LoKoTrOnIc/hellen121vag/modules/readme.md

This folder contains footprints/gerbers/PDFs which hellen-one framework would merge into your frame design.

See https://github.com/andreika-git/hellen-one/wiki for module documentation
