LoKoTrOnIc/hellen121vag/boards/hellen121vag-d/board/hellen121vag-d.png

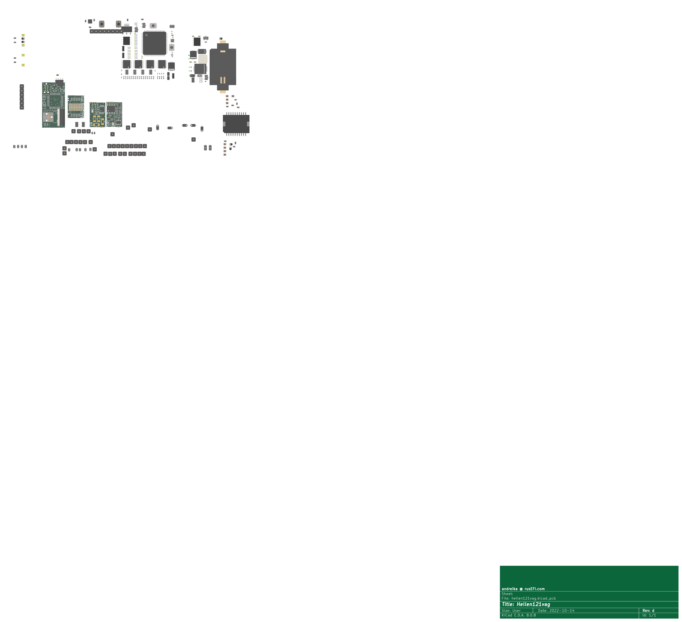
boards/hellen121vag-d/board/hellen121vag-d.png
