LoKoTrOnIc/hellen121vag/boards/hellen121vag-d/board/misc/hellen121vag-d-bottom.png

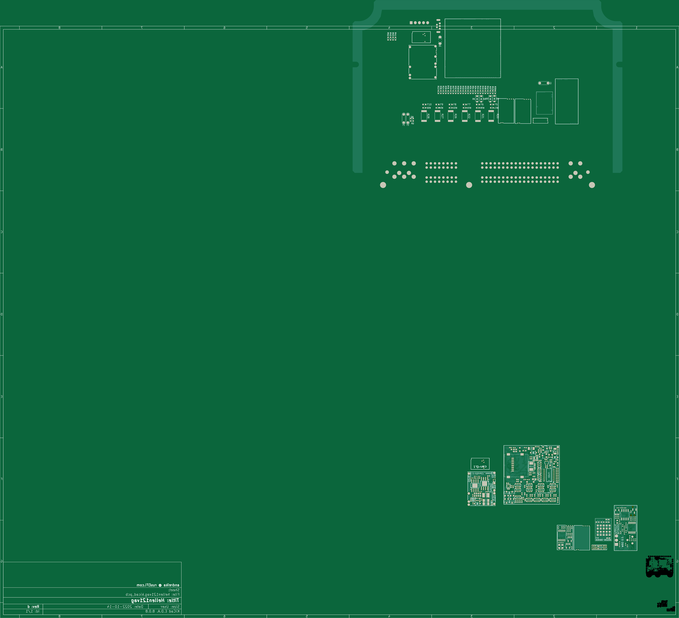
boards/hellen121vag-d/board/misc/hellen121vag-d-bottom.png
