LoKoTrOnIc/hellen121vag/boards/hellen121vag-d/board/misc/hellen121vag-d-top.png

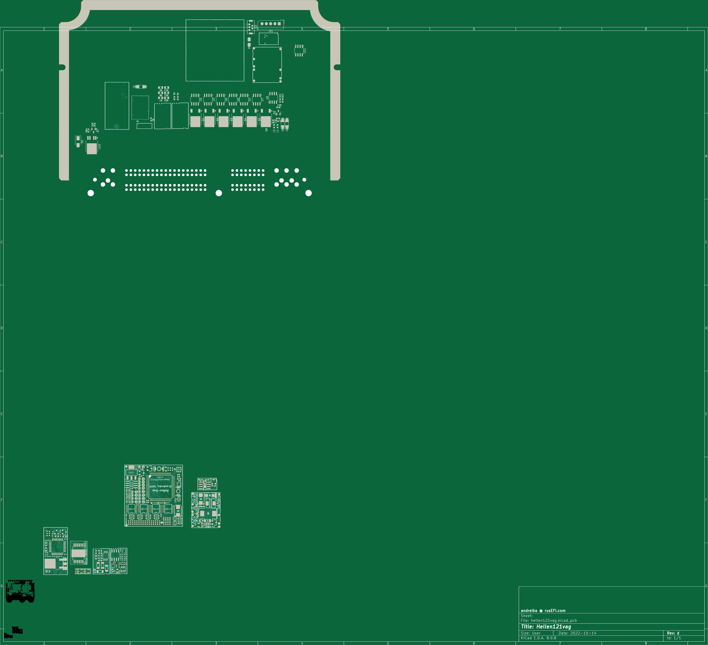
boards/hellen121vag-d/board/misc/hellen121vag-d-top.png
