LoKoTrOnIc/hellen121vag/modules/wbo/wbo-0.3-migration.png

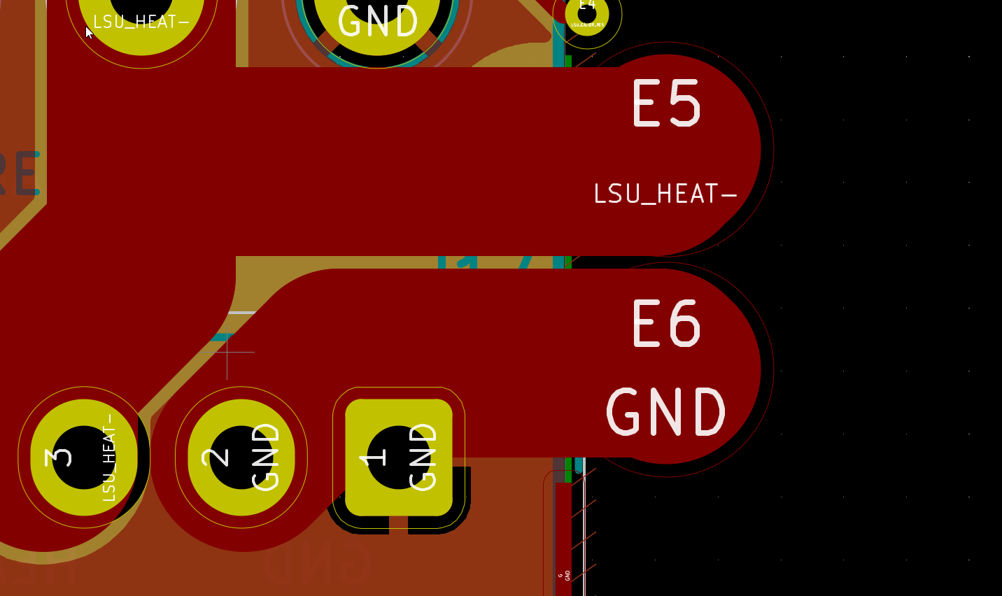
modules/wbo/wbo-0.3-migration.png
