LoKoTrOnIc/hellen121vag/modules/ign8/0.1/ign8-BOM.csv

Comment | Designator | Footprint | LCSC Part #
100n | C460, C461 | C0603 | C14663
Module:ign8/0.1 | M460
10 | R461, R462, R463, R464, R466, R467, R468, R469 | R0603 | C22859
SN74LVC4245APWR | U460 | TSSOP24 | C7859
