LoKoTrOnIc/hellen121vag/modules/knock/0.1/knock-BOM.csv

Comment | Designator | Footprint | LCSC Part #
100n | C470 | C0603 | C14663
3.3n | C471 | C0603 | C1613
330p | C472 | C0603 | C1664
47p | C473 | C0603 | C1671
680p | C474 | C0603 | C1630
Module:knock/0.1 | M470
470k | R470 | R0603 | C23178
100k | R471, R473 | R0603 | C25803
12k | R472 | R0603 | C22790
33k | R474 | R0603 | C4216
LMV321IDBVR | U470, U471 | SOT23-5 | C7972
