LoKoTrOnIc/hellen121vag/modules/power12/0.2/power12-BOM.csv

Comment | Designator | Footprint | LCSC Part #
47u | C410, C412 | C1206 | C96123
100n | C411, C413 | C0603 | C14663
1N4148WS | D410, D412, D413, D414 | SOD-323 | C2128
PSM712-LF | D411 | SOT-23 | C32677
B5819W | D416, D417 | SOD-123 | C8598
SMCJ30A | D418 | SMC | C310046
SMD1206P050TF/24 | F410 | SMD1206 | C209741
Hellen One : Power-12V Module interface | M410
6.8k | R410, R413 | R0603 | C23212
33k | R411 | R0603 | C4216
MIC5205-3.3YM5 | U410 | SOT23-5 | C37970
