LoKoTrOnIc/hellen121vag/boards/hellen121vag-d/frame/121vag-schematic.pdf

DC Motor Discrete inputs General purpose bus LS & HS outputs

Analog/digital Heater negative Power GND

enable the CAN WAKEUP
input will be unavailable.

analog signal VR-DISCRETE
instead of the knock signal

File: hellen121vag.kicad_sch Sheet: / andreika @ rusEFI.comm


Id: 3/6 Title: File: LS4.kicad_sch Sheet: /LS/ R43


Id: 5/6 Title: File: IGN6.kicad_sch Sheet: /Ignition/ F10




Id: 9/6 Title: File: egt.kicad_sch Sheet: /EGT/
