LoKoTrOnIc/hellen121vag/hellen121vag.kicad_pcb

## KiCad design hellen121vag.kicad_pcb (2025-12-17)

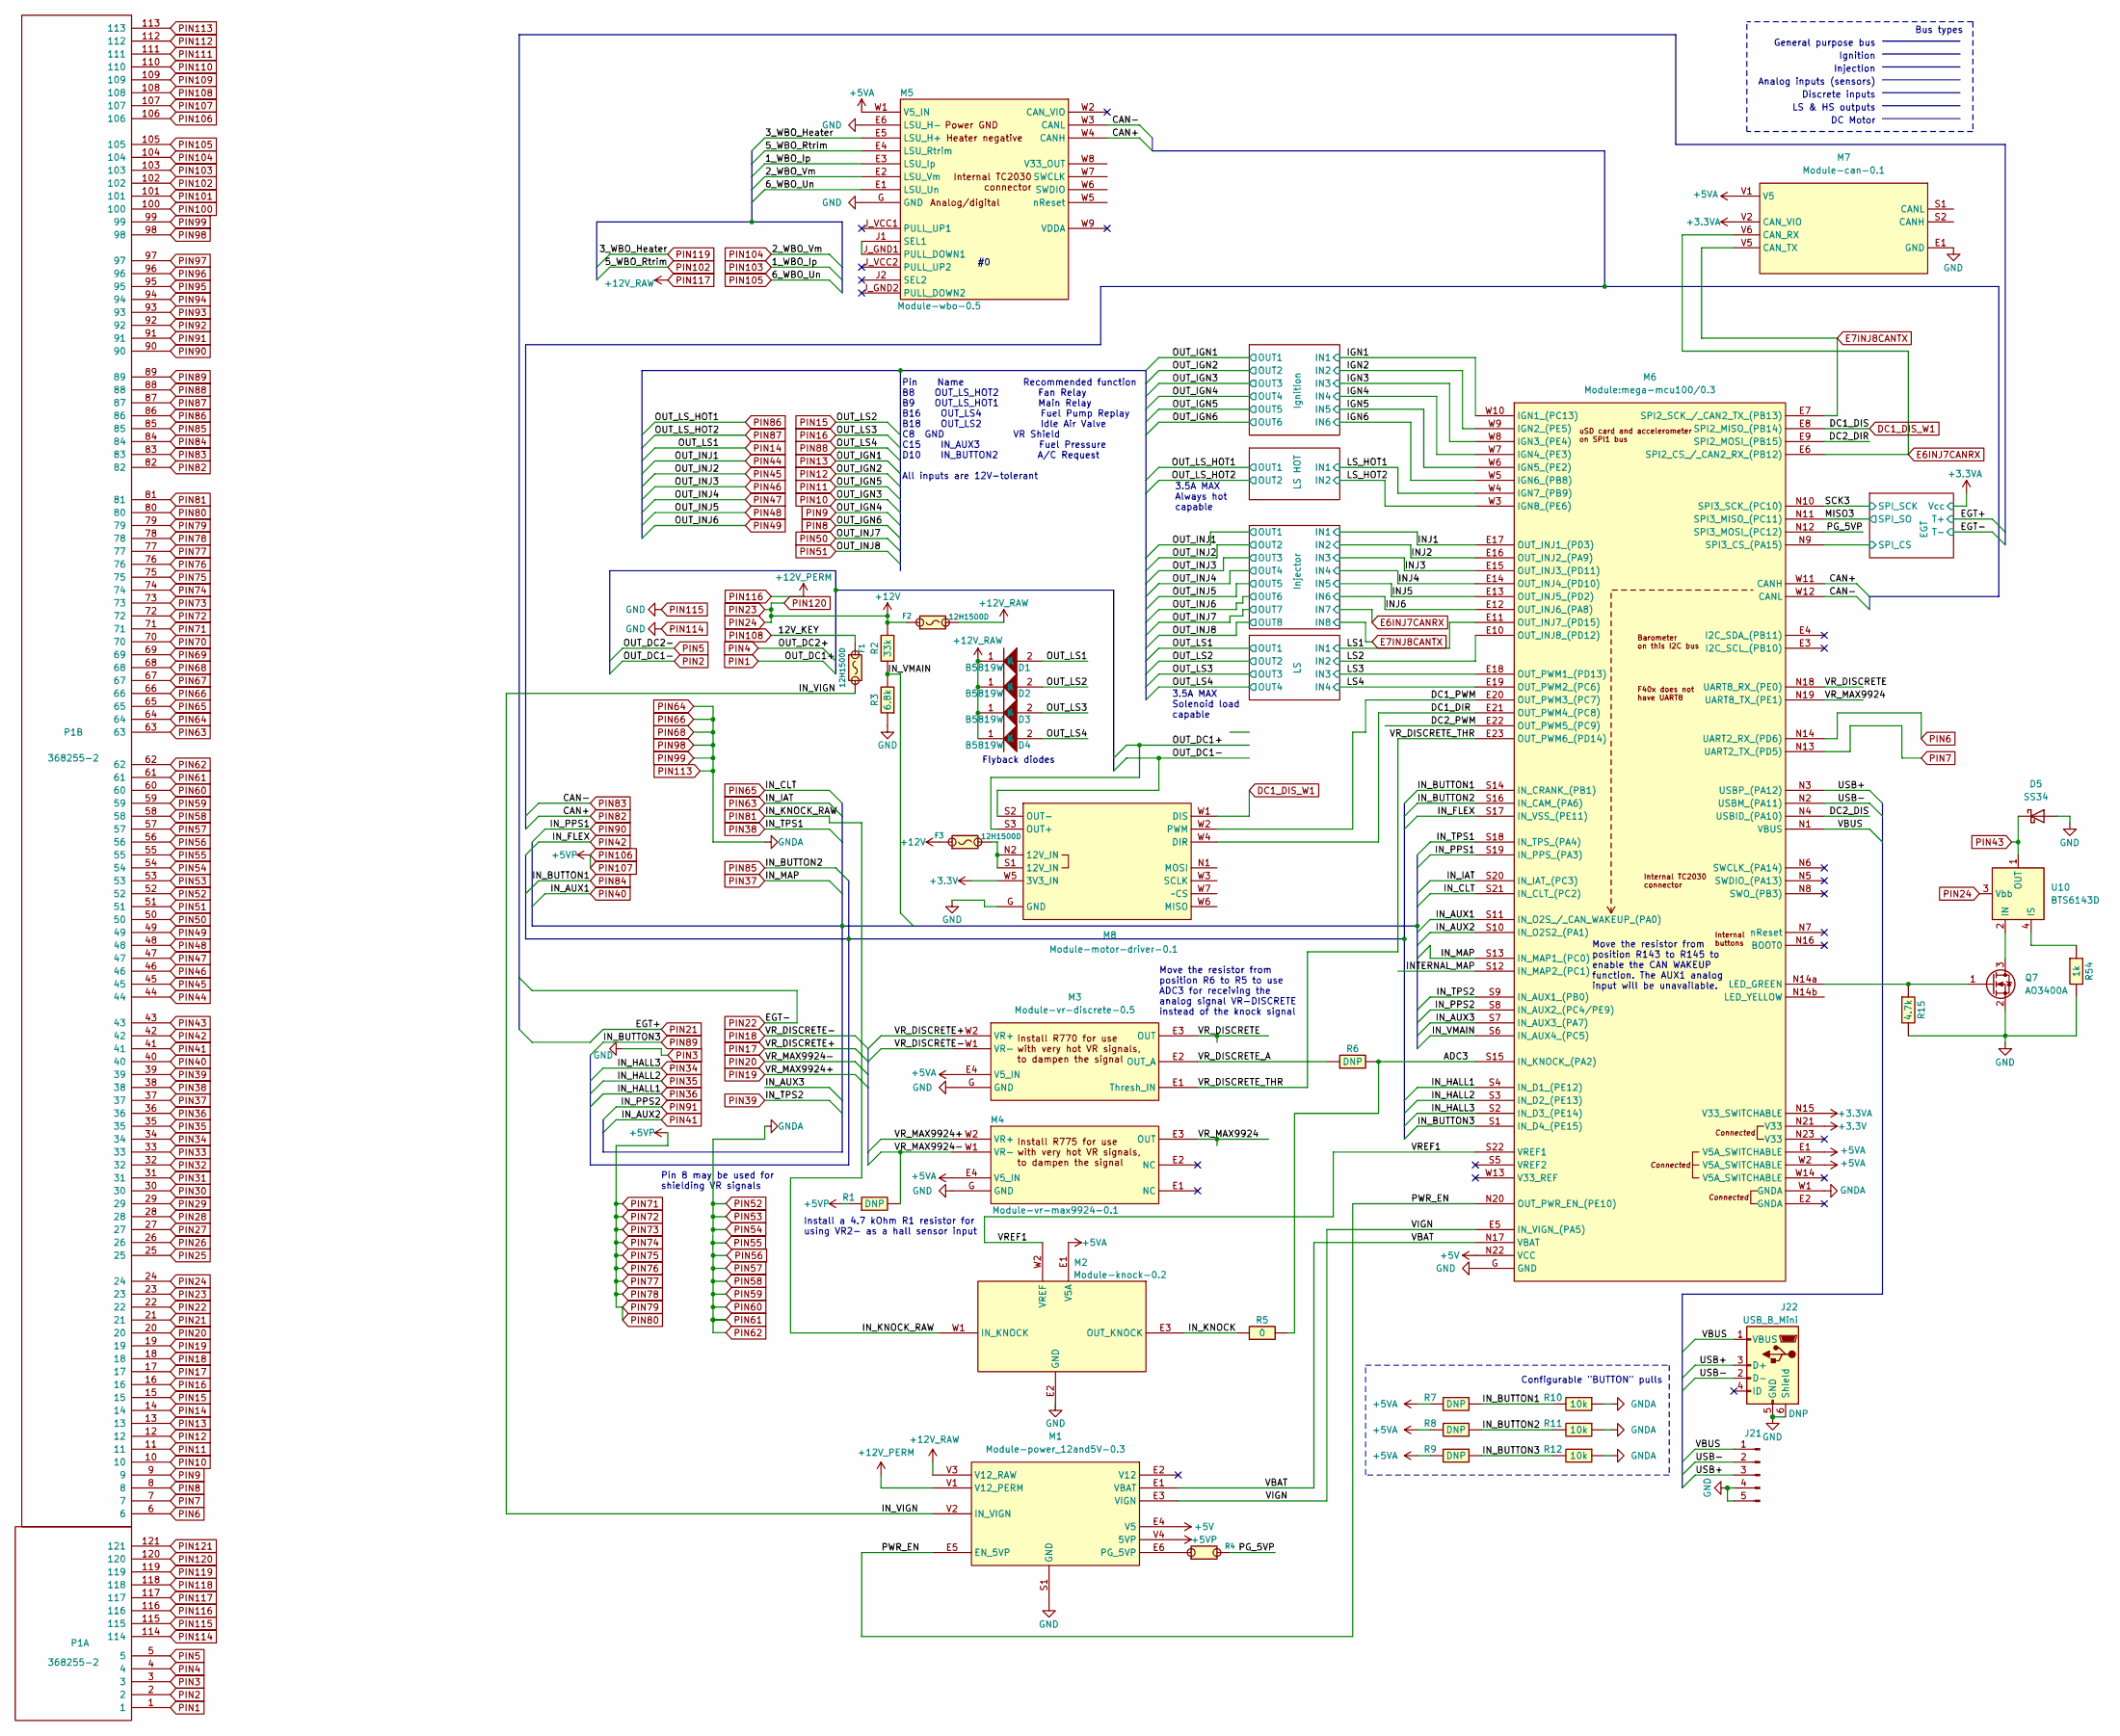
[picture p32: schematic hellen121vag.kicad_sch]

Parts:
D1, D2, D3, D4: B5819W; SOD-123; LCSC C8598
D5: SS34; D_SMA
F1, F2, F3: 12H1500D; PAD-1206-PAD; LCSC C182446
J21: Conn_01x05_Male; Molex_SPOX_5267-05A_1x05_P2.50mm_Vertical
J22: USB_B_Mini; USB-MINI-B-VERTICAL
M1: Module-power_12and5V-0.3; power_12and5V
M2: Module-knock-0.2; knock
M3: Module-vr-discrete-0.5; vr-discrete
M4: Module-vr-max9924-0.1; vr-max9924
M5: Module-wbo-0.5; wbo
M6: Module:mega-mcu100/0.3; mega-mcu100
M7: Module-can-0.1; can
M8: Module-motor-driver-0.1; motor-driver
P1: 368255-2
Q7: AO3400A; SOT-23
R1: 4.7k; R0603
R2: 33k; R0603; LCSC C4216
R3: 6.8k; R0603; LCSC C23212
R4: Jumper-Pad-Pad; PAD-0805-PAD; LCSC C17477
R5: 0; R0603; LCSC C21189
R6: 0; R0603
R7, R8, R9: DNP; R0805
R10, R11, R12: 10k; R0805; LCSC C17414
R15: 4.7k; R0603; LCSC C21189
R54: 1k; R0603; LCSC C21189
U10: BTS6143D; TO-252-4

Connections:
+3.3V: M6.N21 (V33), M8.W5 (3V3_IN)
+3.3VA: M6.N15 (V33_SWITCHABLE), M7.V2 (CAN_VIO); also elsewhere on the board
+5V: M1.E4 (V5), M6.N22 (VCC)
+5VA: M2.E1 (V5A), M3.E4 (V5_IN), M4.E4 (V5_IN), M5.W1 (V5_IN), M6.E1 (V5A_SWITCHABLE), M6.W2 (V5A_SWITCHABLE), M7.V1 (V5), R7.2, R8.2, R9.2
/ADC3: M6.S15 (IN_KNOCK_(PA2)), R5.2, R6.2
/DC1_DIR: M6.E21 (OUT_PWM4_(PC8)), M8.W4 (DIR)
/DC1_PWM: M6.E20 (OUT_PWM3_(PC7)), M8.W2 (PWM)
/DC2_DIR: M6.E9 (SPI2_MOSI_(PB15))
/DC2_DIS: M6.N4 (USBID_(PA10))
/DC2_PWM: M6.E22 (OUT_PWM5_(PC9))
/EGT/SPI_CS: M6.N9 (SPI3_CS_(PA15)); also elsewhere on the board
/IGN1: M6.W10 (IGN1_(PC13)); also elsewhere on the board
/IGN2: M6.W9 (IGN2_(PE5)); also elsewhere on the board
/IGN3: M6.W8 (IGN3_(PE4)); also elsewhere on the board
/IGN4: M6.W7 (IGN4_(PE3)); also elsewhere on the board
/IGN5: M6.W6 (IGN5_(PE2)); also elsewhere on the board
/IGN6: M6.W5 (IGN6_(PB8)); also elsewhere on the board
/INJ1: M6.E17 (OUT_INJ1_(PD3)); also elsewhere on the board
/INJ2: M6.E16 (OUT_INJ2_(PA9)); also elsewhere on the board
/INJ3: M6.E15 (OUT_INJ3_(PD11)); also elsewhere on the board
/INJ4: M6.E14 (OUT_INJ4_(PD10)); also elsewhere on the board
/INJ5: M6.E13 (OUT_INJ5_(PD2)); also elsewhere on the board
/INJ6: M6.E12 (OUT_INJ6_(PA8)); also elsewhere on the board
/INTERNAL_MAP: M6.S12 (IN_MAP2_(PC1))
/IN_AUX3: M6.S7 (IN_AUX3_(PA7))
/IN_KNOCK: M2.E3 (OUT_KNOCK), R5.1
/IN_VIGN: F1.2, M1.V2 (IN_VIGN)
/IN_VMAIN: M6.S6 (IN_AUX4_(PC5)), R2.1, R3.2
/LS1: M6.E11 (OUT_INJ7_(PD15)); also elsewhere on the board
/LS2: M6.E10 (OUT_INJ8_(PD12)); also elsewhere on the board
/LS3: M6.E18 (OUT_PWM1_(PD13)); also elsewhere on the board
/LS4: M6.E19 (OUT_PWM2_(PC6)); also elsewhere on the board
/LS_HOT1: M6.W4 (IGN7_(PB9)); also elsewhere on the board
/LS_HOT2: M6.W3 (IGN8_(PE6)); also elsewhere on the board
/MISO3: M6.N11 (SPI3_MISO_(PC11)); also elsewhere on the board
/PG_5VP: M6.N12 (SPI3_MOSI_(PC12)), R4.2
/PWR_EN: M1.E5 (EN_5VP), M6.N20 (OUT_PWR_EN_(PE10))
/SCK3: M6.N10 (SPI3_SCK_(PC10)); also elsewhere on the board
/USB+: J21.3, J22.3 (D+), M6.N3 (USBP_(PA12))
/USB-: J21.2, J22.2 (D-), M6.N2 (USBM_(PA11))
/VBAT: M1.E1 (VBAT), M6.N17 (VBAT)
/VBUS: J21.1, J22.1 (VBUS), M6.N1 (VBUS)
/VIGN: M1.E3 (VIGN), M6.E5 (IN_VIGN_(PA5))
/VREF1: M2.W2 (VREF), M6.S22 (VREF1)
/VR_DISCRETE: M3.E3 (OUT), M6.N18 (UART8_RX_(PE0))
/VR_DISCRETE_A: M3.E2 (OUT_A), R6.1
/VR_DISCRETE_THR: M3.E1 (Thresh_IN), M6.E23 (OUT_PWM6_(PD14))
/VR_MAX9924: M4.E3 (OUT), M6.N19 (UART8_TX_(PE1))
DC1_DIS_W1: M6.E8 (SPI2_MISO_(PB14)), M8.W1 (DIS)
E6INJ7CANRX: M6.E6 (SPI2_CS_/_CAN2_RX_(PB12)), M7.V6 (CAN_RX); also elsewhere on the board
E7INJ8CANTX: M6.E7 (SPI2_SCK_/_CAN2_TX_(PB13)), M7.V5 (CAN_TX); also elsewhere on the board
unnamed: F3.2, M8.N2 (12V_IN), M8.S1 (12V_IN)
unnamed: M1.E6 (PG_5VP), R4.1
unnamed: M5.J1 (SEL1), M5.J_GND1 (PULL_DOWN1)
unnamed: M6.N14a (LED_GREEN), Q7.1 (G), R15.1
unnamed: Q7.3 (D), U10.2 (IN)
unnamed: R54.1, U10.4 (IS)
PIN1: M8.S3 (OUT+), P1.1
PIN2: M8.S2 (OUT-), P1.2
PIN4: P1.4
PIN5: P1.5
PIN6: M6.N14 (UART2_RX_(PD6)), P1.6
PIN7: M6.N13 (UART2_TX_(PD5)), P1.7
PIN8: P1.8; also elsewhere on the board
PIN9: P1.9; also elsewhere on the board
PIN10: P1.10; also elsewhere on the board
PIN11: P1.11; also elsewhere on the board
PIN12: P1.12; also elsewhere on the board
PIN13: P1.13; also elsewhere on the board
PIN14: D1.2 (A), P1.14; also elsewhere on the board
PIN15: D2.2 (A), P1.15; also elsewhere on the board
PIN16: D3.2 (A), P1.16; also elsewhere on the board
PIN17: M3.W2 (VR+), P1.17
PIN18: M3.W1 (VR-), P1.18
PIN19: M4.W2 (VR+), P1.19
PIN20: M4.W1 (VR-), P1.20, R1.2
PIN21: P1.21; also elsewhere on the board
PIN22: P1.22; also elsewhere on the board
PIN25: P1.25
PIN26: P1.26
PIN27: P1.27
PIN28: P1.28
PIN29: P1.29
PIN30: P1.30
PIN31: P1.31
PIN32: P1.32
PIN33: P1.33
PIN34: M6.S2 (IN_D3_(PE14)), P1.34
PIN35: M6.S3 (IN_D2_(PE13)), P1.35
PIN36: M6.S4 (IN_D1_(PE12)), P1.36
PIN37: M6.S13 (IN_MAP1_(PC0)), P1.37
PIN38: M6.S18 (IN_TPS_(PA4)), P1.38
PIN39: M6.S9 (IN_AUX1_(PB0)), P1.39
PIN40: M6.S11 (IN_O2S_/_CAN_WAKEUP_(PA0)), P1.40
PIN41: M6.S10 (IN_O2S2_(PA1)), P1.41
PIN42: M6.S17 (IN_VSS_(PE11)), P1.42
PIN43: D5.1 (K), P1.43, U10.1 (OUT), U10.5 (OUT)
PIN44: P1.44; also elsewhere on the board
PIN45: P1.45; also elsewhere on the board
PIN46: P1.46; also elsewhere on the board
PIN47: P1.47; also elsewhere on the board
PIN48: P1.48; also elsewhere on the board
PIN49: P1.49; also elsewhere on the board
PIN50: P1.50; also elsewhere on the board
PIN51: P1.51; also elsewhere on the board
PIN63: M6.S20 (IN_IAT_(PC3)), P1.63
PIN65: M6.S21 (IN_CLT_(PC2)), P1.65
PIN67: P1.67
PIN69: P1.69
PIN70: P1.70
PIN81: M2.W1 (IN_KNOCK), P1.81
PIN82: M5.W4 (CANH), M6.W11 (CANH), P1.82
PIN83: M5.W3 (CANL), M6.W12 (CANL), P1.83
PIN84: M6.S14 (IN_CRANK_(PB1)), P1.84, R7.1, R10.2
PIN85: M6.S16 (IN_CAM_(PA6)), P1.85, R8.1, R11.2
PIN86: P1.86; also elsewhere on the board
PIN87: P1.87; also elsewhere on the board
PIN88: D4.2 (A), P1.88; also elsewhere on the board
PIN89: M6.S1 (IN_D4_(PE15)), P1.89, R9.1, R12.2
PIN90: M6.S19 (IN_PPS_(PA3)), P1.90
PIN91: M6.S8 (IN_AUX2_(PC4/PE9)), P1.91
PIN92: P1.92
PIN93: P1.93
PIN94: P1.94
PIN95: P1.95
PIN96: P1.96
PIN97: P1.97
PIN100: P1.100
PIN101: P1.101
PIN102: M5.E4 (LSU_Rtrim), P1.102
PIN103: M5.E3 (LSU_Ip), P1.103
PIN104: M5.E2 (LSU_Vm), P1.104
PIN105: M5.E1 (LSU_Un), P1.105
PIN106: M1.V4 (5VP), P1.71, P1.72, P1.73, P1.74, P1.75, P1.76, P1.77, P1.78, P1.79, P1.80, P1.106, P1.107, R1.1
PIN108: F1.1, P1.108
PIN109: P1.109
PIN110: P1.110
PIN111: P1.111
PIN112: P1.112
PIN113: M6.W1 (GNDA), P1.52, P1.53, P1.54, P1.55, P1.56, P1.57, P1.58, P1.59, P1.60, P1.61, P1.62, P1.64, P1.66, P1.68, P1.98, P1.99, P1.113, R10.1, R11.1, R12.1
PIN114: D5.2 (A), J21.4, J21.5, J22.5 (GND), J22.6 (Shield), M1.S1 (GND), M2.E2 (GND), M3.G (GND), M4.G (GND), M5.E6 (LSU_H-), M5.G (GND), M6.G (GND), M7.E1 (GND), M8.G (GND), P1.3, P1.114, P1.115, Q7.2 (S), R3.1, R15.2, R54.2; also elsewhere on the board
PIN116: M1.V1 (V12_PERM), P1.116
PIN117: D1.1 (K), D2.1 (K), D3.1 (K), D4.1 (K), F2.2, M1.V3 (V12_RAW), P1.117
PIN118: P1.118
PIN119: M5.E5 (LSU_H+), P1.119
PIN120: F2.1, F3.1, P1.23, P1.24, P1.120, R2.2, U10.3 (Vbb)
PIN121: P1.121

Notes on the sheet:
Analog inputs (sensors)
Install a 4.7 kOhm R1 resistor for using VR2- as a hall sensor input
Injection
Pin Name Recommended function B8 OUT_LS_HOT2 Fan Relay B9 OUT_LS_HOT1 Main Relay B16 OUT_LS4 Fuel Pump Replay B18 OUT_LS2 Idle Air Valve C8 GND VR Shield C15 IN_AUX3 Fuel Pressure D10 IN_BUTTON2 A/C Request All inputs are 12V-tolerant
Ignition
Move the resistor from position R143 to R145 to enable the CAN WAKEUP function. The AUX1 analog input will be unavailable.
Flyback diodes
DC Motor
Discrete inputs
3.5A MAX Solenoid load capable
Pin 8 may be used for shielding VR signals
General purpose bus
Bus types
Configurable "BUTTON" pulls
3.5A MAX Always hot capable
LS & HS outputs
Move the resistor from position R6 to R5 to use ADC3 for receiving the analog signal VR-DISCRETE instead of the knock signal

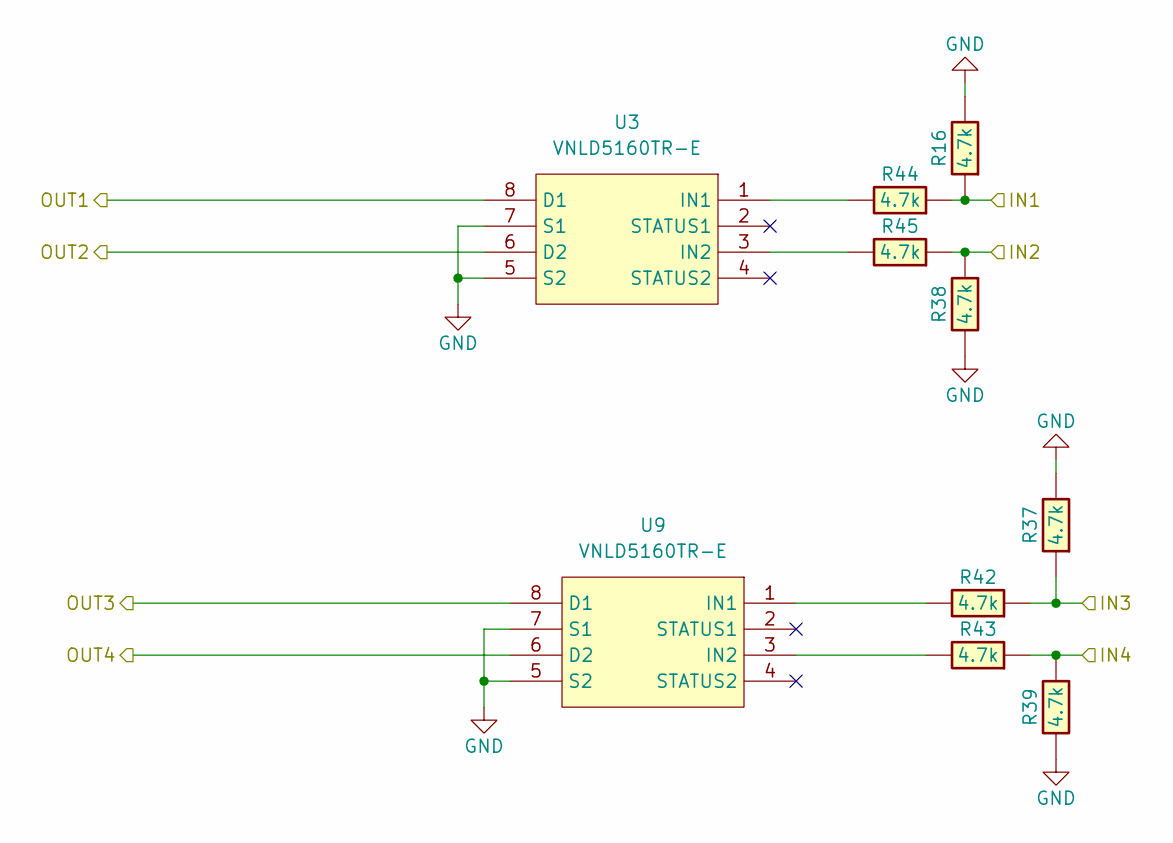
[picture p33: schematic LS4.kicad_sch]

Parts:
R16, R37, R38, R39, R42, R43, R44, R45: 4.7k; R0603; LCSC C23162
U3, U9: VNLD5160TR-E; SOIC-8_3.9x4.9mm_P1.27mm; LCSC C377942

Connections:
/LS1: R16.1, R44.1; also elsewhere on the board
/LS2: R38.1, R45.1; also elsewhere on the board
/LS3: R37.1, R42.1; also elsewhere on the board
/LS4: R39.1, R43.1; also elsewhere on the board
unnamed: R44.2, U3.1 (IN1)
unnamed: R45.2, U3.3 (IN2)
unnamed: R42.2, U9.1 (IN1)
unnamed: R43.2, U9.3 (IN2)
PIN14: U3.8 (D1); also elsewhere on the board
PIN15: U3.6 (D2); also elsewhere on the board
PIN16: U9.8 (D1); also elsewhere on the board
PIN88: U9.6 (D2); also elsewhere on the board
PIN114: R16.2, R37.2, R38.2, R39.2, U3.5 (S2), U3.7 (S1), U9.5 (S2), U9.7 (S1); also elsewhere on the board

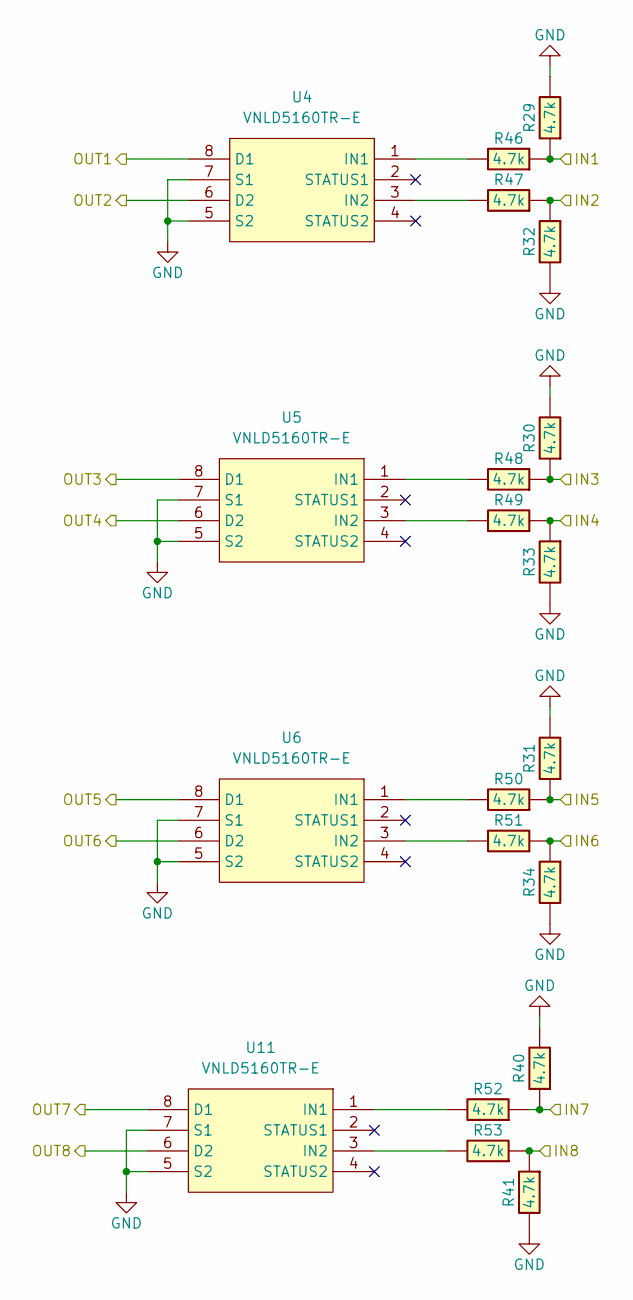
[picture p34: schematic INJ6.kicad_sch]

Parts:
R29, R30, R31, R32, R33, R34, R40, R41, R46, R47, R48, R49, R50, R51, R52, R53: 4.7k; R0603; LCSC C23162
U4, U5, U6, U11: VNLD5160TR-E; SOIC-8_3.9x4.9mm_P1.27mm; LCSC C377942

Connections:
/INJ1: R29.1, R46.1; also elsewhere on the board
/INJ2: R32.1, R47.1; also elsewhere on the board
/INJ3: R30.1, R48.1; also elsewhere on the board
/INJ4: R33.1, R49.1; also elsewhere on the board
/INJ5: R31.1, R50.1; also elsewhere on the board
/INJ6: R34.1, R51.1; also elsewhere on the board
E6INJ7CANRX: R40.1, R52.1; also elsewhere on the board
E7INJ8CANTX: R41.1, R53.1; also elsewhere on the board
unnamed: R46.2, U4.1 (IN1)
unnamed: R47.2, U4.3 (IN2)
unnamed: R48.2, U5.1 (IN1)
unnamed: R49.2, U5.3 (IN2)
unnamed: R50.2, U6.1 (IN1)
unnamed: R51.2, U6.3 (IN2)
unnamed: R52.2, U11.1 (IN1)
unnamed: R53.2, U11.3 (IN2)
PIN44: U4.8 (D1); also elsewhere on the board
PIN45: U4.6 (D2); also elsewhere on the board
PIN46: U5.8 (D1); also elsewhere on the board
PIN47: U5.6 (D2); also elsewhere on the board
PIN48: U6.8 (D1); also elsewhere on the board
PIN49: U6.6 (D2); also elsewhere on the board
PIN50: U11.8 (D1); also elsewhere on the board
PIN51: U11.6 (D2); also elsewhere on the board
PIN114: R29.2, R30.2, R31.2, R32.2, R33.2, R34.2, R40.2, R41.2, U4.5 (S2), U4.7 (S1), U5.5 (S2), U5.7 (S1), U6.5 (S2), U6.7 (S1), U11.5 (S2), U11.7 (S1); also elsewhere on the board

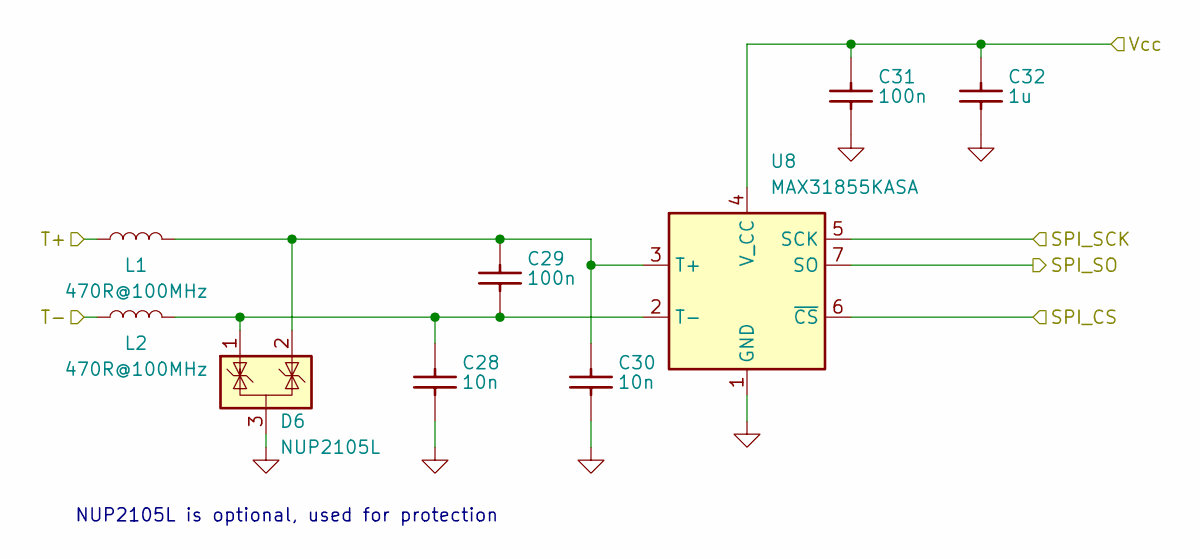
[picture p35: schematic egt.kicad_sch]

Parts:
C28, C30: 10n; C0603; LCSC C57112
C29, C31: 100n; C0603; LCSC C14663
C32: 1u; C0603; LCSC C15849
D6: NUP2105L; SOT-23; LCSC C284104
L1, L2: 470R@100MHz; L_0603_1608Metric; LCSC C97853
U8: MAX31855KASA; SOIC-8_3.9x4.9mm_P1.27mm; LCSC C52028

Connections:
+3.3VA: C31.2, C32.2, U8.4 (V_CC); also elsewhere on the board
/EGT/SPI_CS: U8.6 (~CS); also elsewhere on the board
/MISO3: U8.7 (SO); also elsewhere on the board
/SCK3: U8.5 (SCK); also elsewhere on the board
unnamed: C29.2, C30.2, D6.2 (K), L1.2, U8.3 (T+)
unnamed: C28.2, C29.1, D6.1 (K), L2.2, U8.2 (T-)
PIN21: L1.1; also elsewhere on the board
PIN22: L2.1; also elsewhere on the board
PIN114: C28.1, C30.1, C31.1, C32.1, D6.3 (A), U8.1 (GND); also elsewhere on the board

Notes on the sheet:
NUP2105L is optional, used for protection

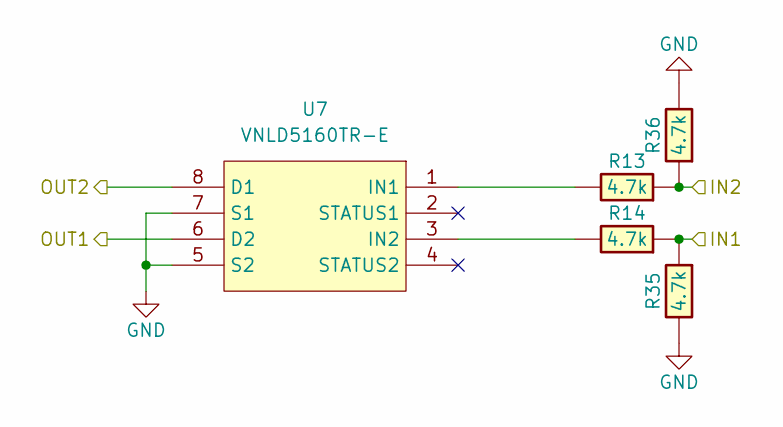
[picture p36: schematic LS_HOT.kicad_sch]

Parts:
R13, R14, R35, R36: 4.7k; R0603; LCSC C23162
U7: VNLD5160TR-E; SOIC-8_3.9x4.9mm_P1.27mm; LCSC C377942

Connections:
/LS_HOT1: R14.1, R35.1; also elsewhere on the board
/LS_HOT2: R13.1, R36.1; also elsewhere on the board
unnamed: R13.2, U7.1 (IN1)
unnamed: R14.2, U7.3 (IN2)
PIN86: U7.6 (D2); also elsewhere on the board
PIN87: U7.8 (D1); also elsewhere on the board
PIN114: R35.2, R36.2, U7.5 (S2), U7.7 (S1); also elsewhere on the board

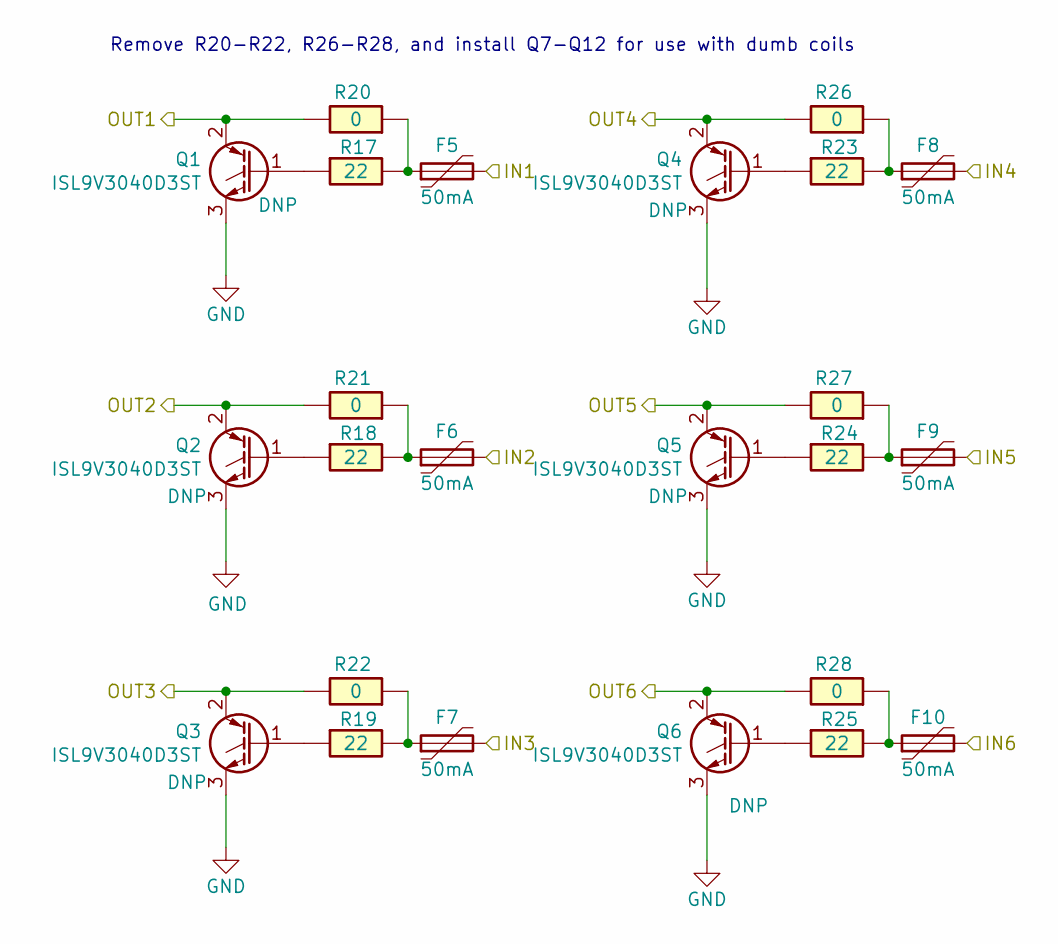
[picture p37: schematic IGN6.kicad_sch]

Parts:
F5, F6, F7, F8, F9, F10: 50mA; Fuse_0603_1608Metric; LCSC C369141
Q1, Q2, Q3, Q4, Q5, Q6: ISL9V3040D3ST; TO-252-2
R17, R18, R19, R23, R24, R25: 22; R0603; LCSC C23345
R20, R21, R22, R26, R27, R28: 0; R_2512_6332Metric; LCSC C25469

Connections:
/IGN1: F5.2; also elsewhere on the board
/IGN2: F6.2; also elsewhere on the board
/IGN3: F7.2; also elsewhere on the board
/IGN4: F8.2; also elsewhere on the board
/IGN5: F9.2; also elsewhere on the board
/IGN6: F10.2; also elsewhere on the board
unnamed: F5.1, R17.2, R20.1
unnamed: F6.1, R18.2, R21.1
unnamed: F7.1, R19.2, R22.1
unnamed: F8.1, R23.2, R26.1
unnamed: F9.1, R24.2, R27.1
unnamed: F10.1, R25.2, R28.1
unnamed: Q1.1 (G), R17.1
unnamed: Q2.1 (G), R18.1
unnamed: Q3.1 (G), R19.1
unnamed: Q4.1 (G), R23.1
unnamed: Q5.1 (G), R24.1
unnamed: Q6.1 (G), R25.1
PIN8: Q6.2 (C), R28.2; also elsewhere on the board
PIN9: Q4.2 (C), R26.2; also elsewhere on the board
PIN10: Q3.2 (C), R22.2; also elsewhere on the board
PIN11: Q5.2 (C), R27.2; also elsewhere on the board
PIN12: Q2.2 (C), R21.2; also elsewhere on the board
PIN13: Q1.2 (C), R20.2; also elsewhere on the board
PIN114: Q1.3 (E), Q2.3 (E), Q3.3 (E), Q4.3 (E), Q5.3 (E), Q6.3 (E); also elsewhere on the board

Notes on the sheet:
Remove R20-R22, R26-R28, and install Q7-Q12 for use with dumb coils

Board: 4 copper layers, 103 parts (52 on the bottom side), 142 nets, no tracks yet.
