LoKoTrOnIc/hellen121vag/(commit log)

2025-12-07 modifico archive de revision
    [DC_MOTOR_0.1.kicad_sch, IGN6.kicad_sch, INJ6.kicad_sch, LS4.kicad_sch, LS_HOT.kicad_sch, MAP.kicad_sch, egt.kicad_sch, hellen121vag.kicad_sch]
2025-12-07 [skip actions] Auto-generated board
    [121vag-BOM.csv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]
2025-12-07 Se agrego by avelito
    [hellen121vag-B_Cu.gbl, hellen121vag-B_Mask.gbs, hellen121vag-B_Silkscreen.gbo, hellen121vag-Edge_Cuts.gm1, hellen121vag-F_Cu.gtl, hellen121vag-F_Mask.gts, hellen121vag-F_Paste.gtp, hellen121vag-F_Silkscreen.gto]
2025-12-08 se modifico esquema y pcb
    [hellen121vag.kicad_pcb, hellen121vag.kicad_sch]
2025-12-10 colocacion de los componentes en un 90%
    [DC_MOTOR_0.1.kicad_sch, IGN6.kicad_sch, INJ6.kicad_sch, LS4.kicad_sch, LS_HOT.kicad_sch, egt.kicad_sch, hellen121vag.kicad_pcb, hellen121vag.kicad_sch]
2025-12-10 se ha completado un 99% la colocacion de componentes y adapatacion
    [hellen121vag.kicad_pcb]
2025-12-10 se hace un test de la modificacion
    [hellen121vag-B_Cu.gbl, hellen121vag-B_Mask.gbs, hellen121vag-B_Silkscreen.gbo, hellen121vag-Edge_Cuts.gm1, hellen121vag-F_Cu.gtl, hellen121vag-F_Mask.gts, hellen121vag-F_Paste.gtp, hellen121vag-F_Silkscreen.gto]
2025-12-10 colocacion de componentes 100%
    [hellen121vag-B_Cu.gbl, hellen121vag-B_Mask.gbs, hellen121vag-B_Silkscreen.gbo, hellen121vag-Edge_Cuts.gm1, hellen121vag-F_Cu.gtl, hellen121vag-F_Mask.gts, hellen121vag-F_Paste.gtp, hellen121vag-F_Silkscreen.gto]
2025-12-10 agregue el bom
    [hellen121vag.csv, hellen121vag.kicad_pcb]
2025-12-11 bom add f6
    [hellen121vag.csv]
2025-12-11 fallo el bom por que faltan agregar componentes: se estan agregando los componentes segun log
    [hellen121vag.csv]
2025-12-11 se agrego f10
    [hellen121vag.csv]
2025-12-15 [skip actions] Auto-generated board v2.1
    [121vag-BOM.csv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]
